ammaralvi21/Couch-Surfer-Robot/Datasheets/TT_Motor.jpg

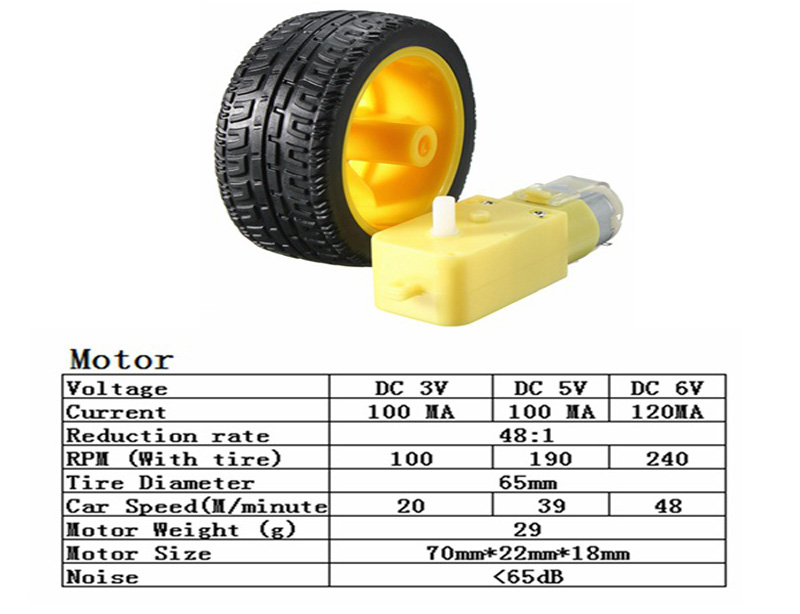
Datasheets/TT_Motor.jpg
