ammaralvi21/Couch-Surfer-Robot/Project_Files/UTIL.h

/******************************************************************************
 * Name:    UTIL.h
 * Description: Utility function used for various purposes 
 * Version: V1.00
 * Author: Ammar Alvi & Shannon D'Souza
 *
 * This software is supplied "AS IS" without warranties of any kind.
 *
 *
 *----------------------------------------------------------------------------
 * History:
 *          V1.00 Initial Version
 *****************************************************************************/
#include <stdint.h>


  void delay(uint32_t delay);
 uint8_t to_ascii(uint16_t val);
